lucasfutch/Arduino-Robot/images/reactivision-source.JPG

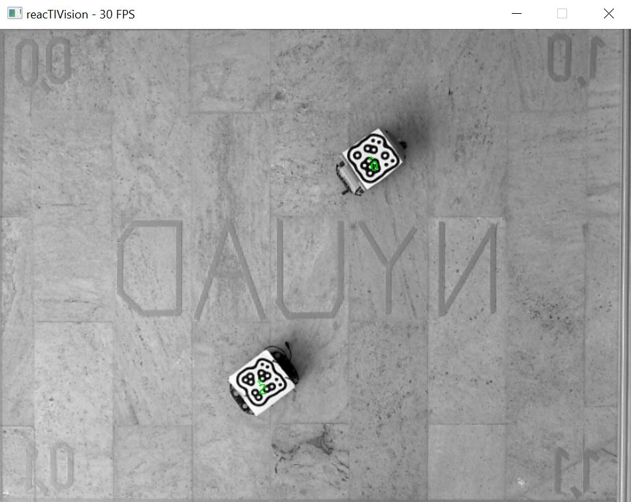
images/reactivision-source.JPG
