lucasfutch/Arduino-Robot/images/reactivision.JPG

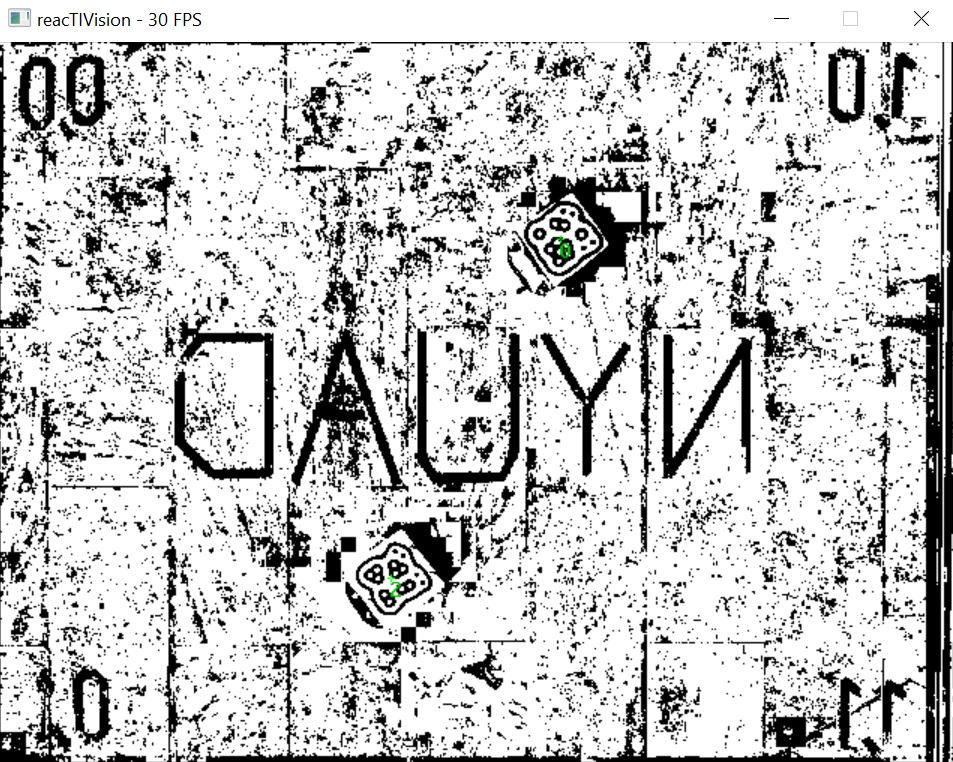
images/reactivision.JPG
