lucasfutch/Arduino-Robot/images/sideview2.jpg

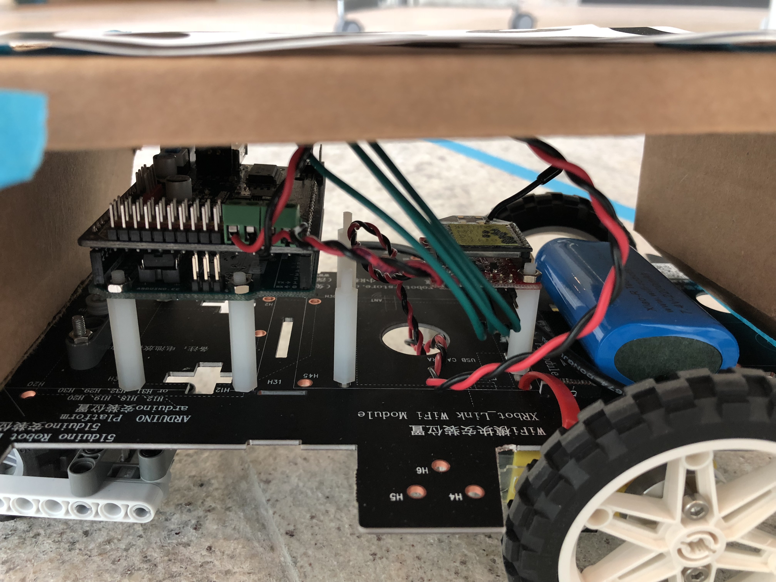
images/sideview2.jpg
