lucasfutch/Arduino-Robot/(threads)

Thread 1 (2018-04-02):

Finish documentation

dbcarelli, 2018-04-02:
Lucas:
1) user manual + installation
2) video
3) take pics of caster wheel
4) Add in throughput calculations - mention that maximum is actually 30 times per second because camera limitation

Dani:
1) Put graphs and explanation of PID attempt
2) Put pictures of AHRS
3) Add reactivation pics
4) explain why we used reactivision

dbcarelli, 2018-04-02:
Dani:
-Explain why we used XBee

lucasfutch, 2018-04-07:
done

Closed 2018-04-07.
