lucasfutch/Arduino-Robot/reacTIVision-windows-64bit/symbols/amoeba/small.pdf

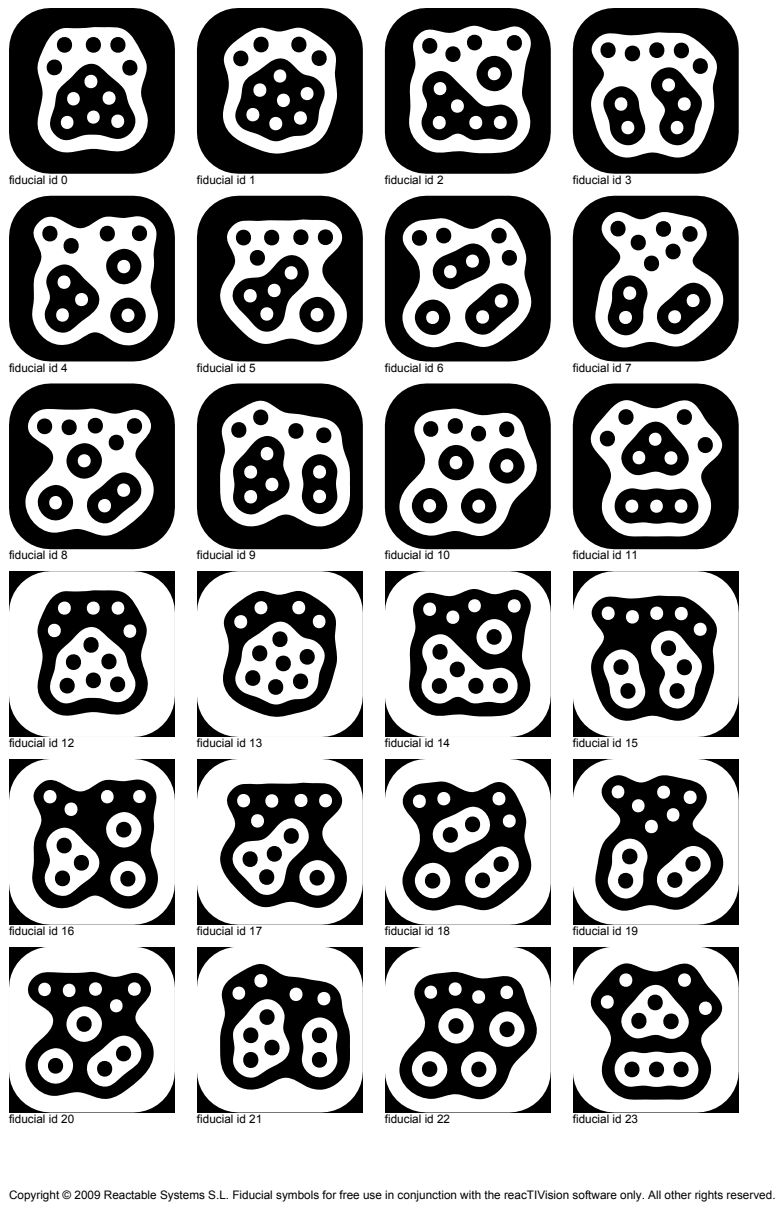
[picture p10: page 1]
fiducial id 0; fiducial id 1; fiducial id 2; fiducial id 3; fiducial id 4; fiducial id 5; fiducial id 6; fiducial id 7; fiducial id 8; fiducial id 9; fiducial id 10; fiducial id 11; fiducial id 12; fiducial id 13; fiducial id 14; fiducial id 15; fiducial id 16; fiducial id 17; fiducial id 18; fiducial id 19; fiducial id 20; fiducial id 21; fiducial id 22; fiducial id 23

Copyright © 2009 Reactable Systems S.L. Fiducial symbols for free use in conjunction with the reacTIVision software only. All other rights reserved.
