lucasfutch/Arduino-Robot/reacTIVision-windows-64bit/symbols/amoeba/legacy.pdf

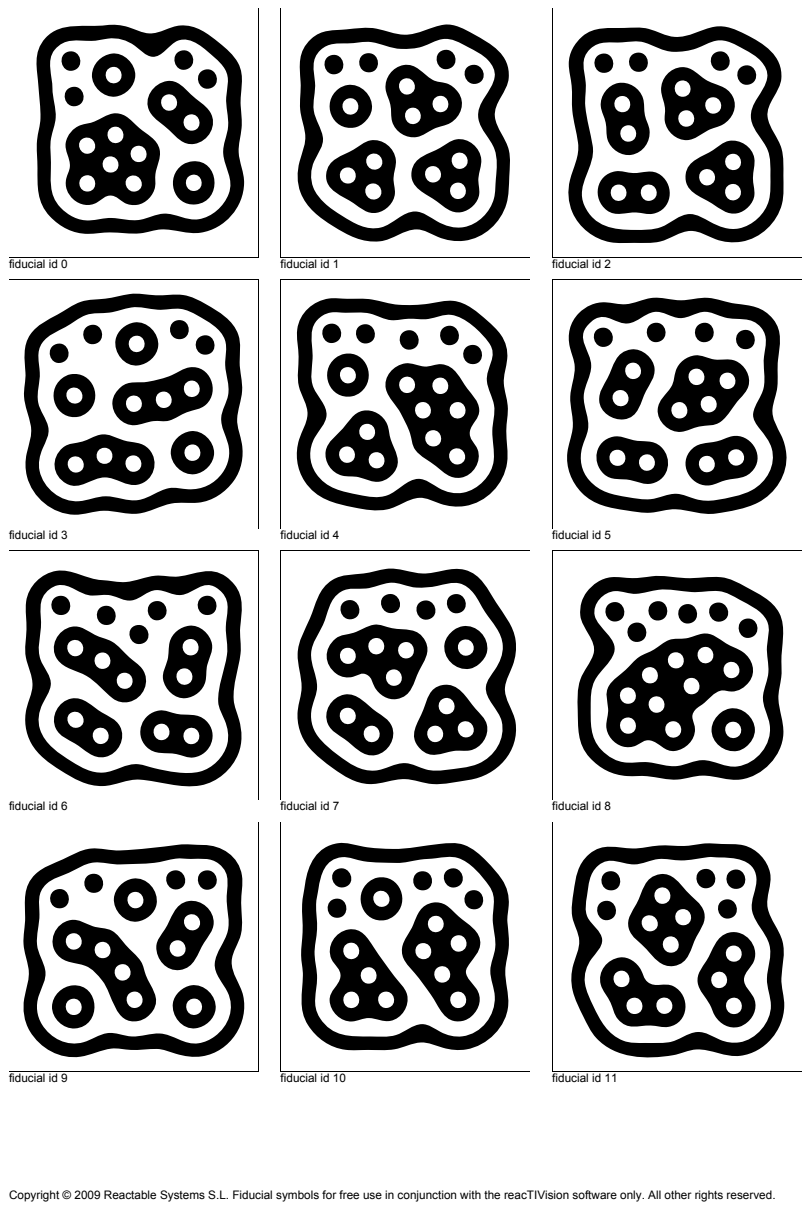
[picture p11: page 1]
fiducial id 0; fiducial id 1; fiducial id 2; fiducial id 3; fiducial id 4; fiducial id 5; fiducial id 6; fiducial id 7; fiducial id 8; fiducial id 9; fiducial id 10; fiducial id 11

Copyright © 2009 Reactable Systems S.L. Fiducial symbols for free use in conjunction with the reacTIVision software only. All other rights reserved.

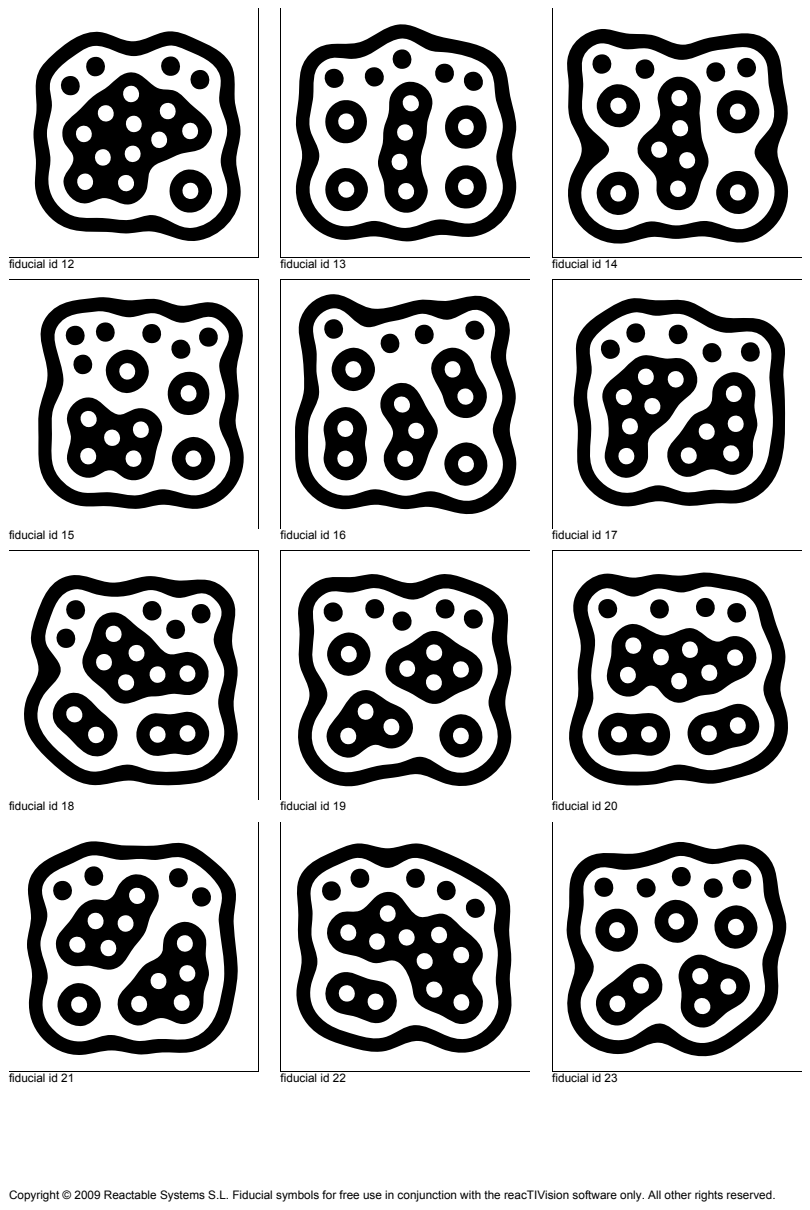
[picture p12: page 2]
fiducial id 12; fiducial id 13; fiducial id 14; fiducial id 15; fiducial id 16; fiducial id 17; fiducial id 18; fiducial id 19; fiducial id 20; fiducial id 21; fiducial id 22; fiducial id 23

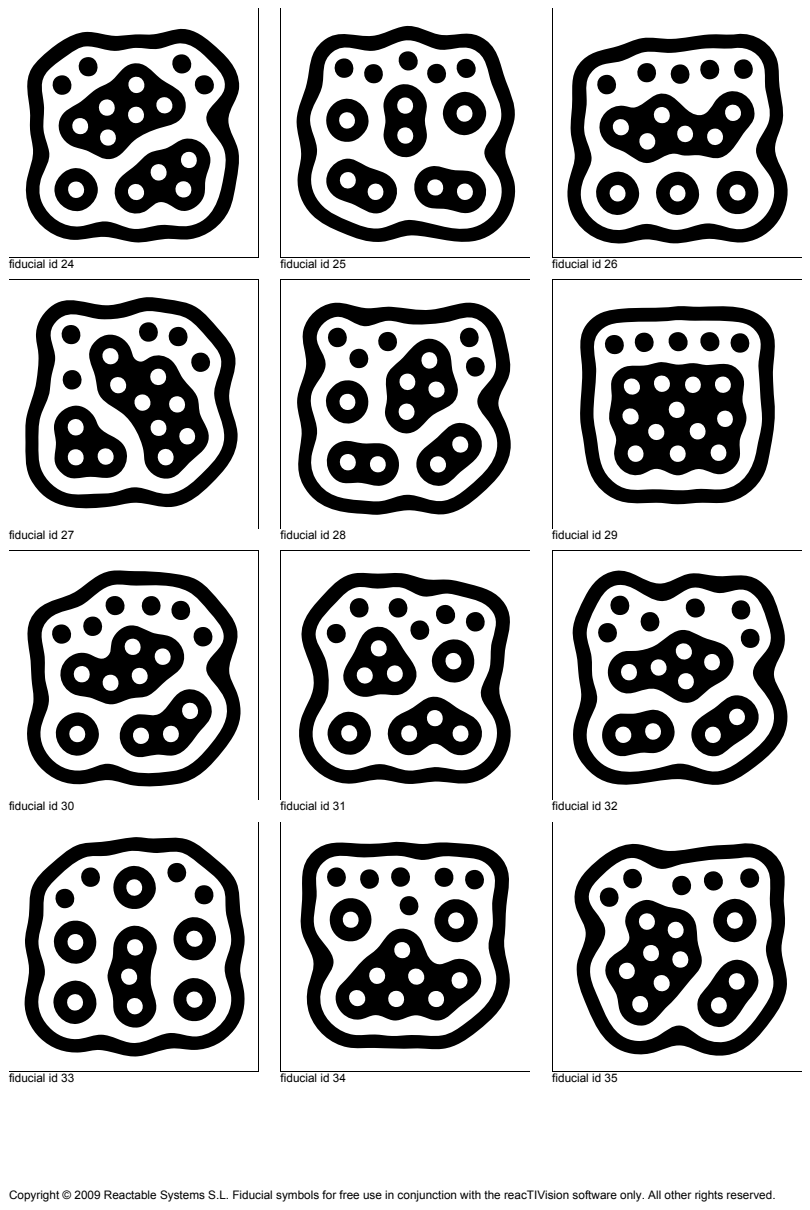
[picture p13: page 3]
fiducial id 24; fiducial id 25; fiducial id 26; fiducial id 27; fiducial id 28; fiducial id 29; fiducial id 30; fiducial id 31; fiducial id 32; fiducial id 33; fiducial id 34; fiducial id 35

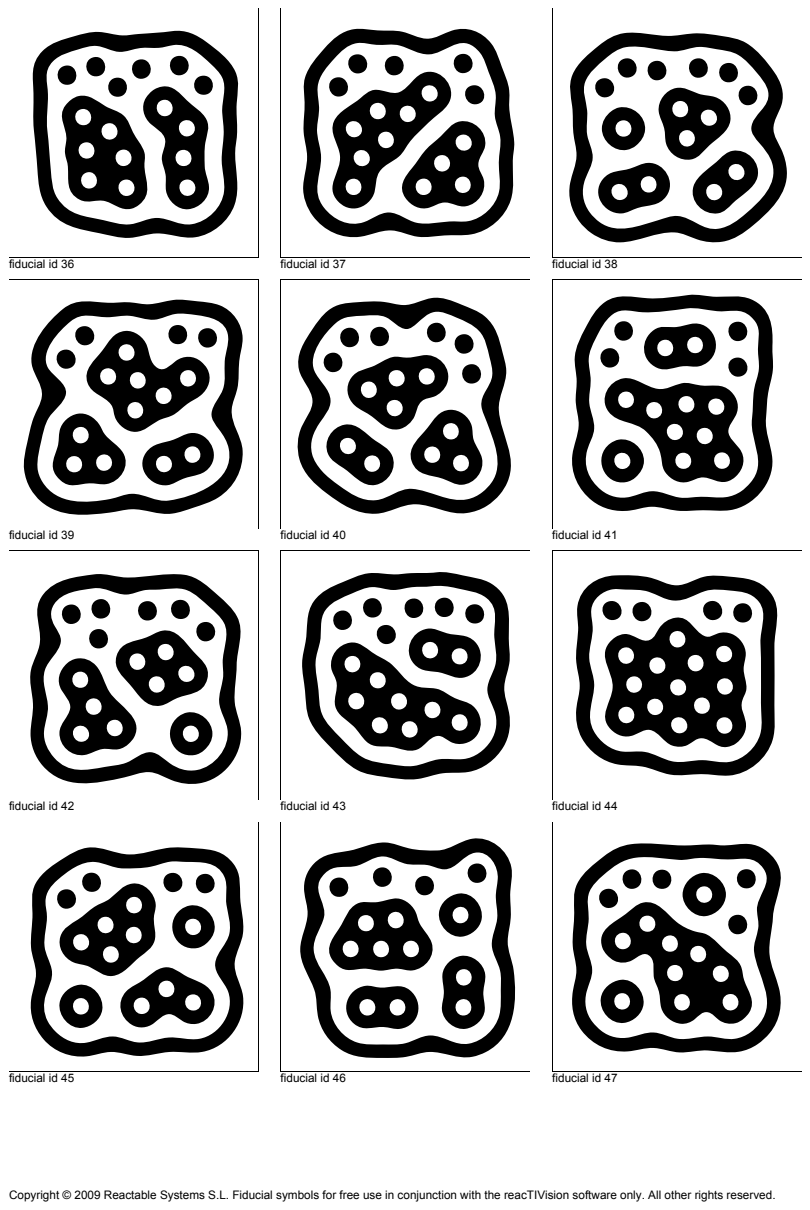
[picture p14: page 4]
fiducial id 36; fiducial id 37; fiducial id 38; fiducial id 39; fiducial id 40; fiducial id 41; fiducial id 42; fiducial id 43; fiducial id 44; fiducial id 45; fiducial id 46; fiducial id 47

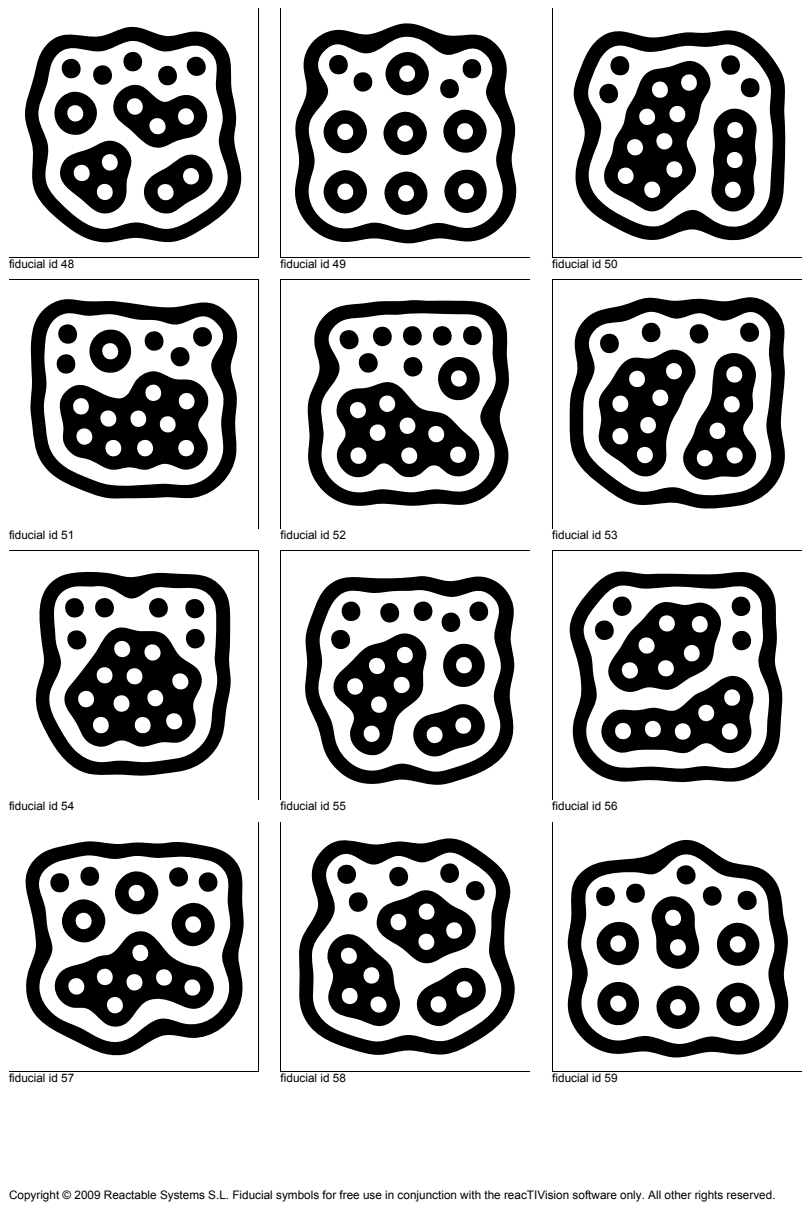
[picture p15: page 5]
fiducial id 48; fiducial id 49; fiducial id 50; fiducial id 51; fiducial id 52; fiducial id 53; fiducial id 54; fiducial id 55; fiducial id 56; fiducial id 57; fiducial id 58; fiducial id 59

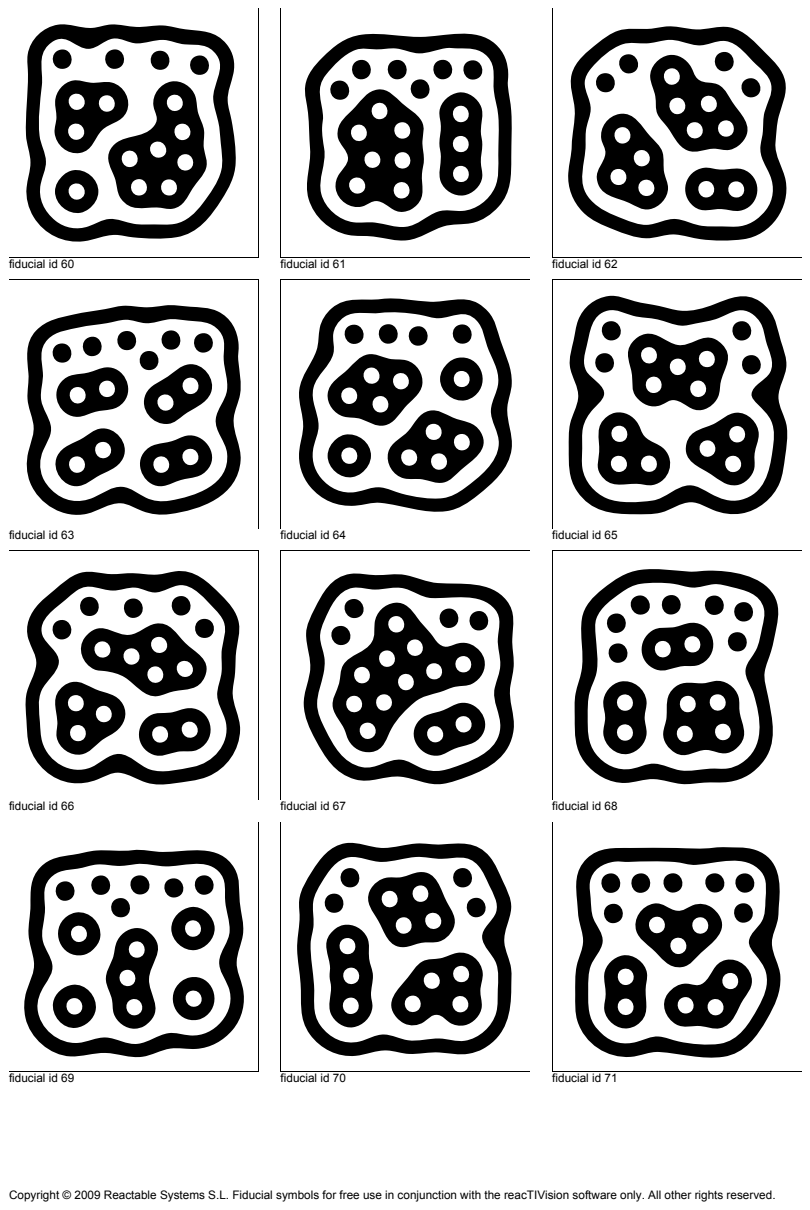
[picture p16: page 6]
fiducial id 60; fiducial id 61; fiducial id 62; fiducial id 63; fiducial id 64; fiducial id 65; fiducial id 66; fiducial id 67; fiducial id 68; fiducial id 69; fiducial id 70; fiducial id 71

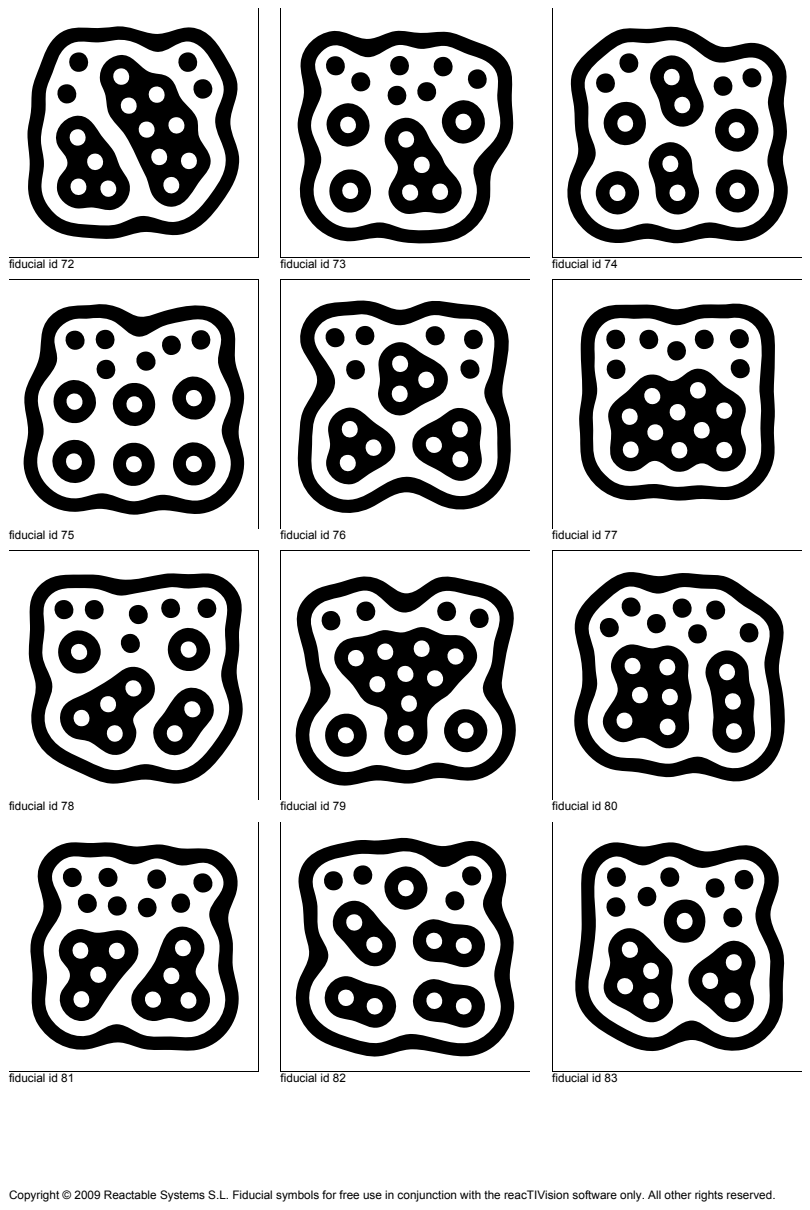
[picture p17: page 7]
fiducial id 72; fiducial id 73; fiducial id 74; fiducial id 75; fiducial id 76; fiducial id 77; fiducial id 78; fiducial id 79; fiducial id 80; fiducial id 81; fiducial id 82; fiducial id 83

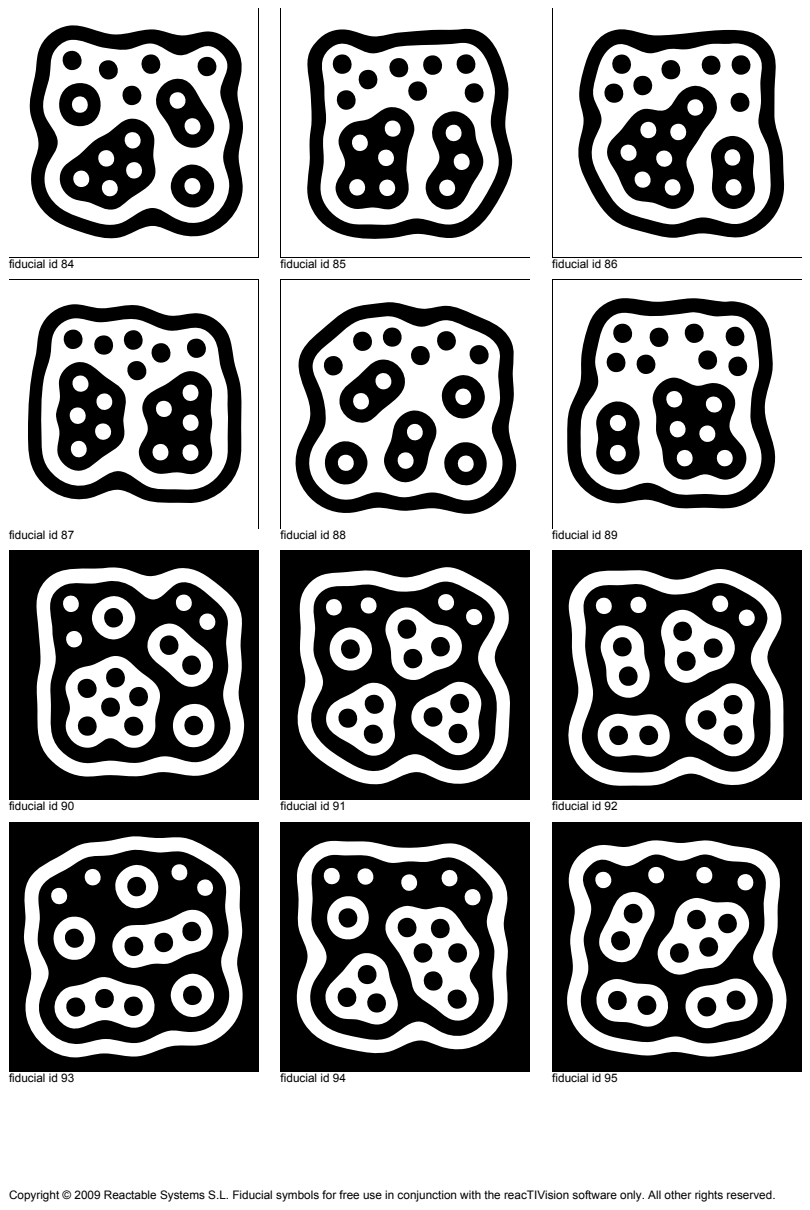
[picture p18: page 8]
fiducial id 84; fiducial id 85; fiducial id 86; fiducial id 87; fiducial id 88; fiducial id 89; fiducial id 90; fiducial id 91; fiducial id 92; fiducial id 93; fiducial id 94; fiducial id 95

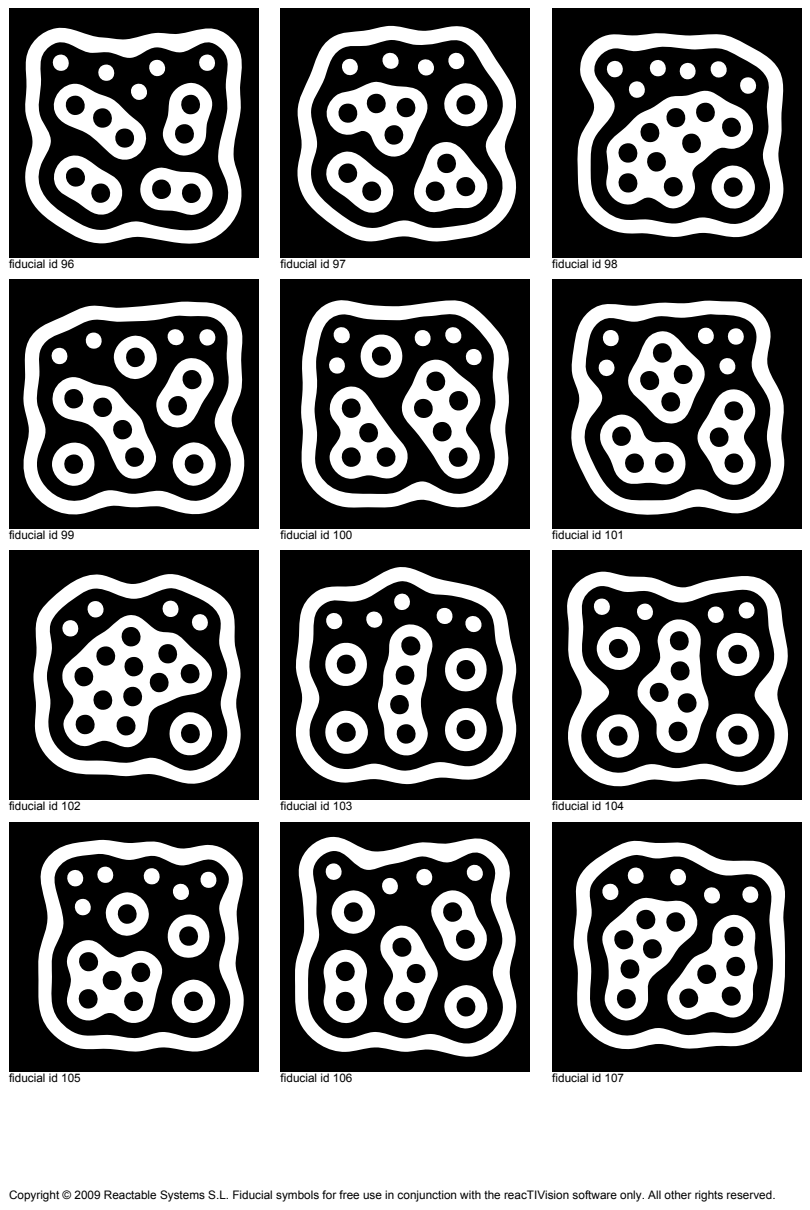
[picture p19: page 9]
fiducial id 96; fiducial id 97; fiducial id 98; fiducial id 99; fiducial id 100; fiducial id 101; fiducial id 102; fiducial id 103; fiducial id 104; fiducial id 105; fiducial id 106; fiducial id 107

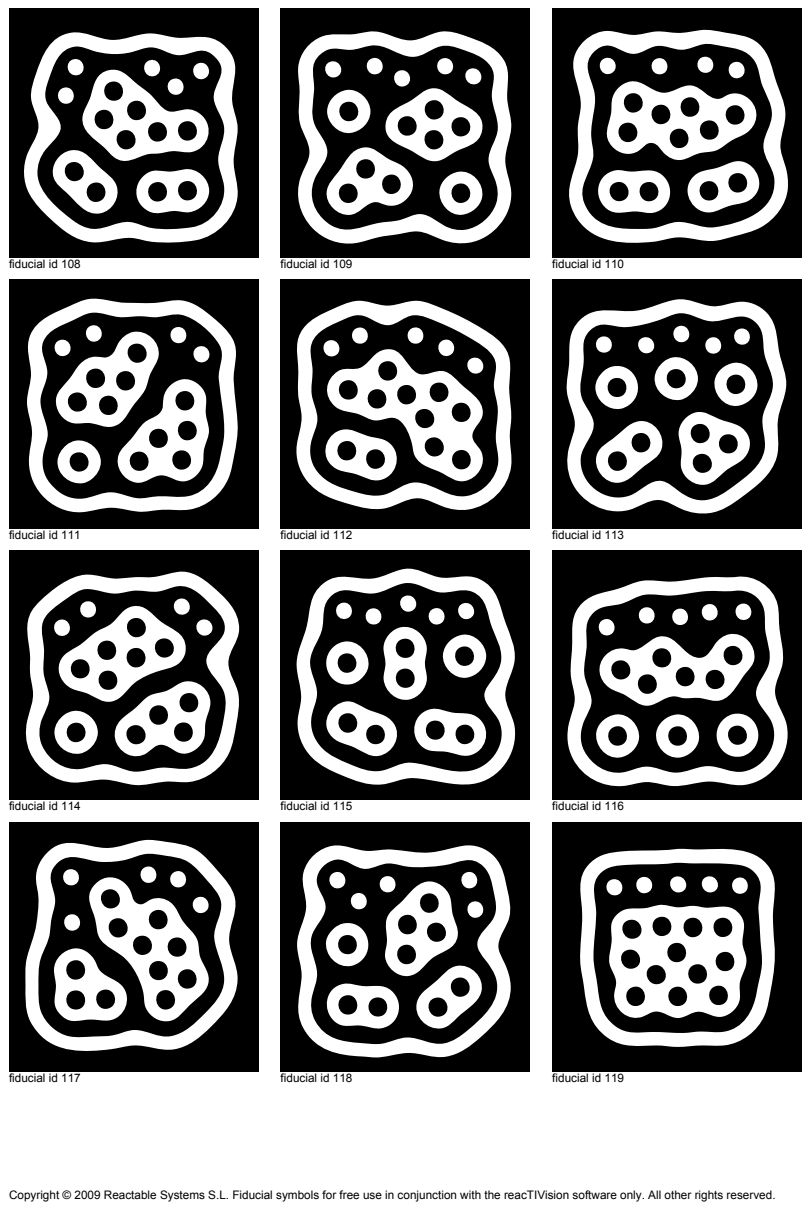
[picture p20: page 10]
fiducial id 108; fiducial id 109; fiducial id 110; fiducial id 111; fiducial id 112; fiducial id 113; fiducial id 114; fiducial id 115; fiducial id 116; fiducial id 117; fiducial id 118; fiducial id 119

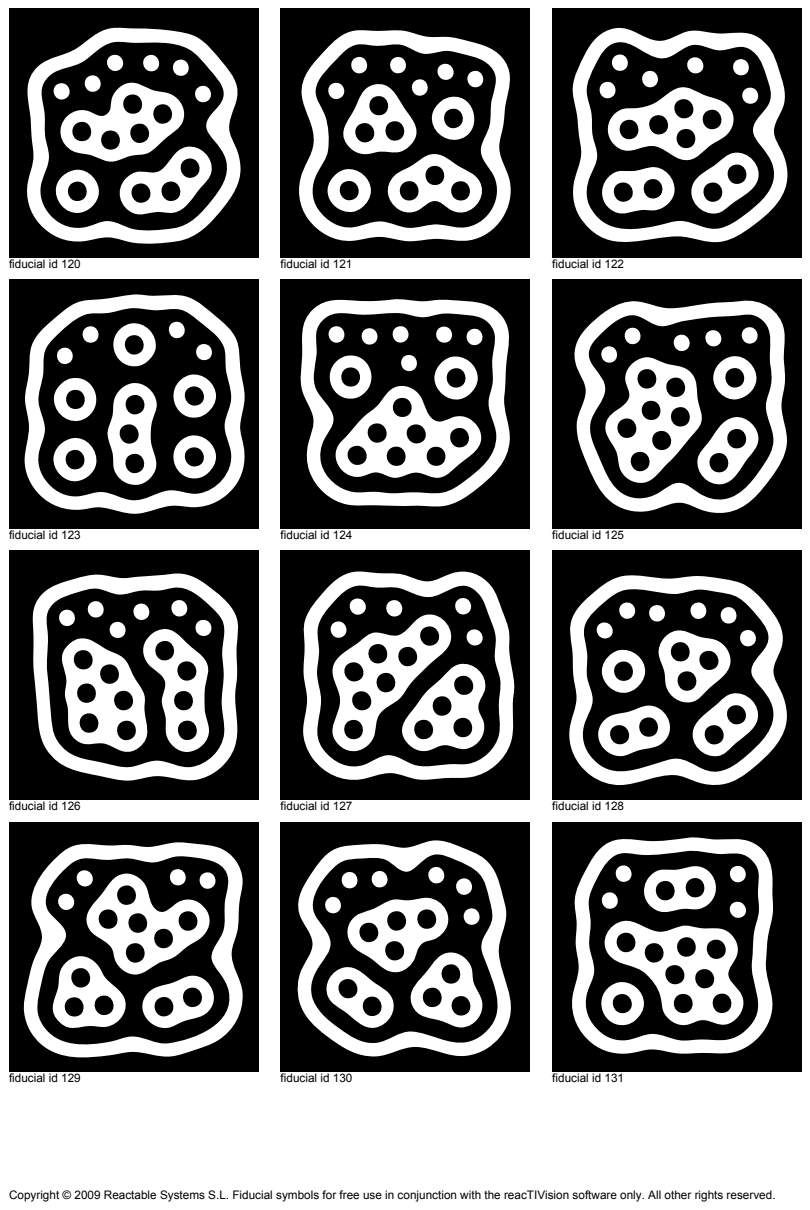
[picture p21: page 11]
fiducial id 120; fiducial id 121; fiducial id 122; fiducial id 123; fiducial id 124; fiducial id 125; fiducial id 126; fiducial id 127; fiducial id 128; fiducial id 129; fiducial id 130; fiducial id 131

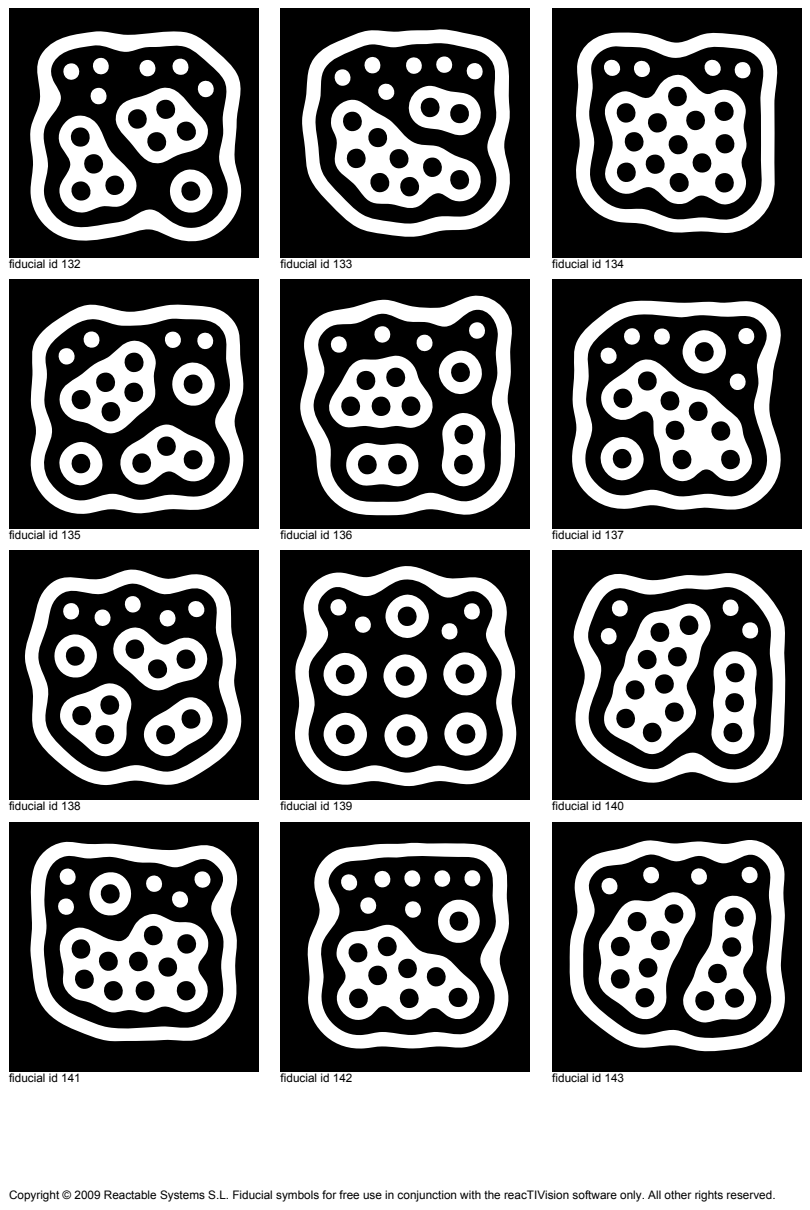
[picture p22: page 12]
fiducial id 132; fiducial id 133; fiducial id 134; fiducial id 135; fiducial id 136; fiducial id 137; fiducial id 138; fiducial id 139; fiducial id 140; fiducial id 141; fiducial id 142; fiducial id 143

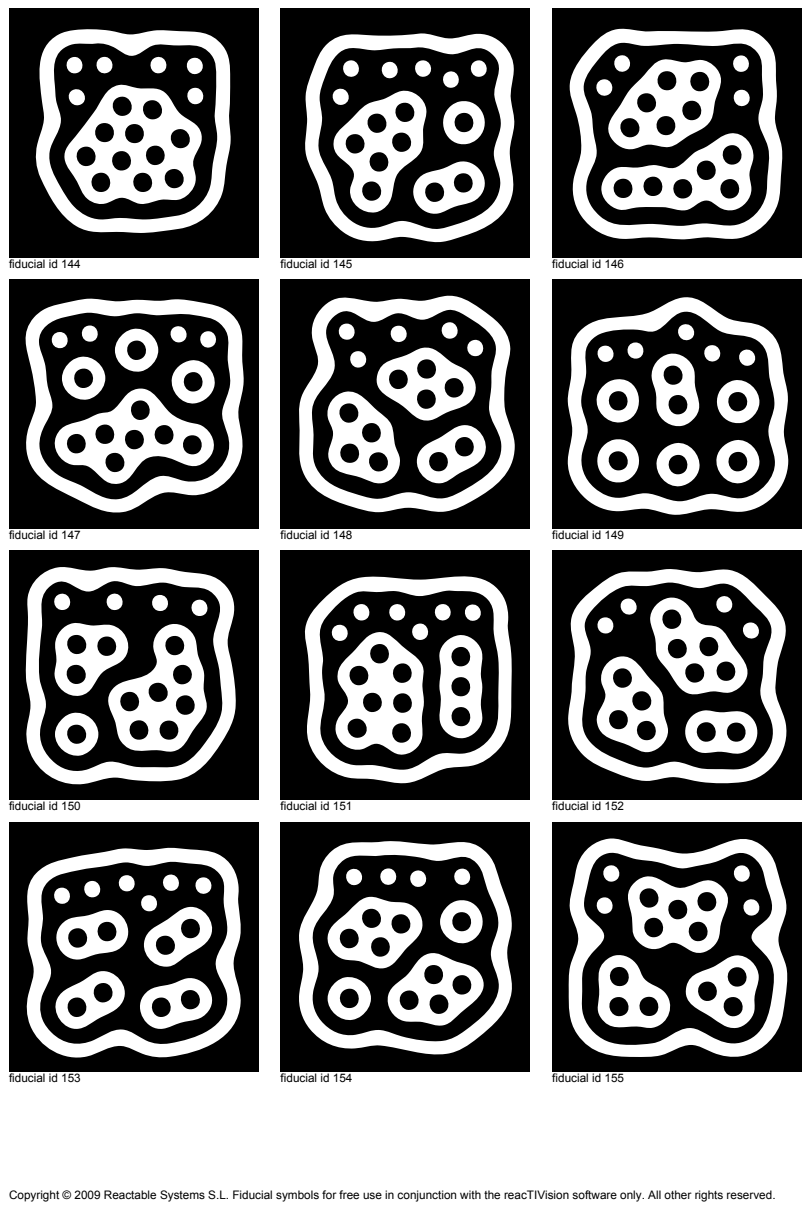
[picture p23: page 13]
fiducial id 144; fiducial id 145; fiducial id 146; fiducial id 147; fiducial id 148; fiducial id 149; fiducial id 150; fiducial id 151; fiducial id 152; fiducial id 153; fiducial id 154; fiducial id 155

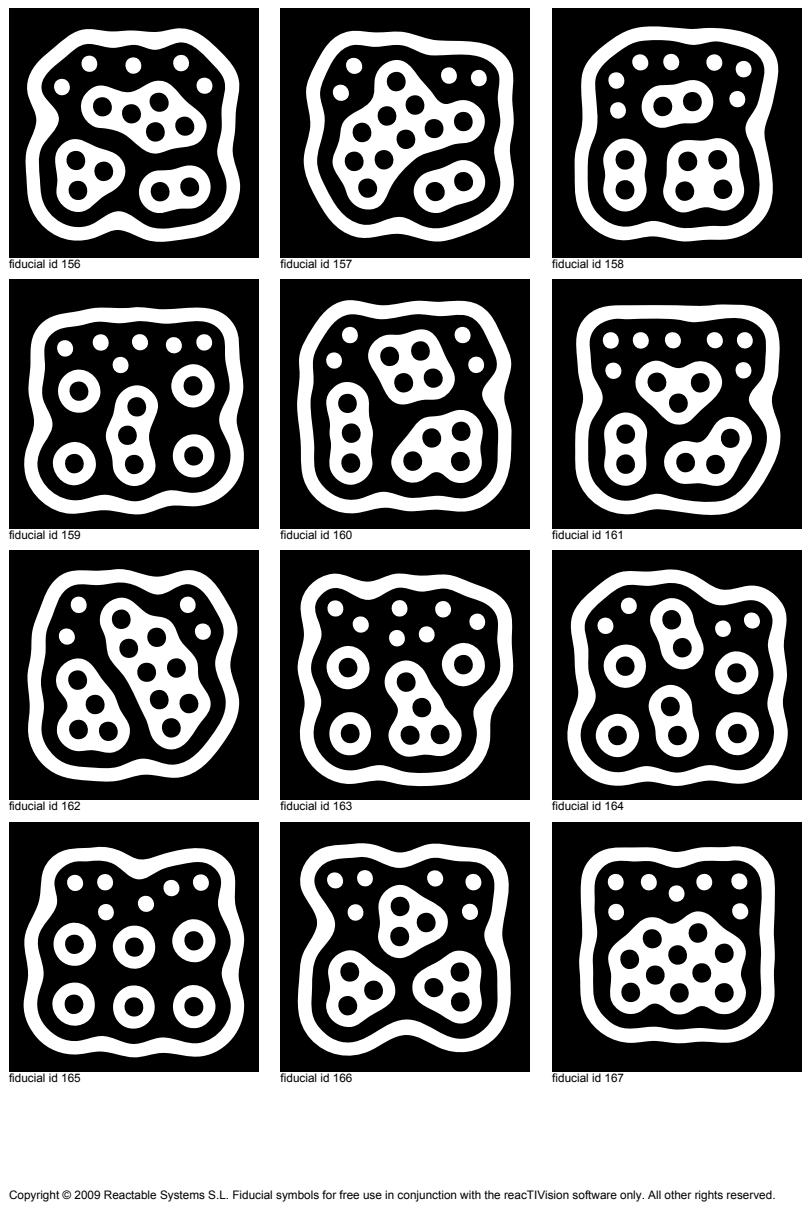
[picture p24: page 14]
fiducial id 156; fiducial id 157; fiducial id 158; fiducial id 159; fiducial id 160; fiducial id 161; fiducial id 162; fiducial id 163; fiducial id 164; fiducial id 165; fiducial id 166; fiducial id 167

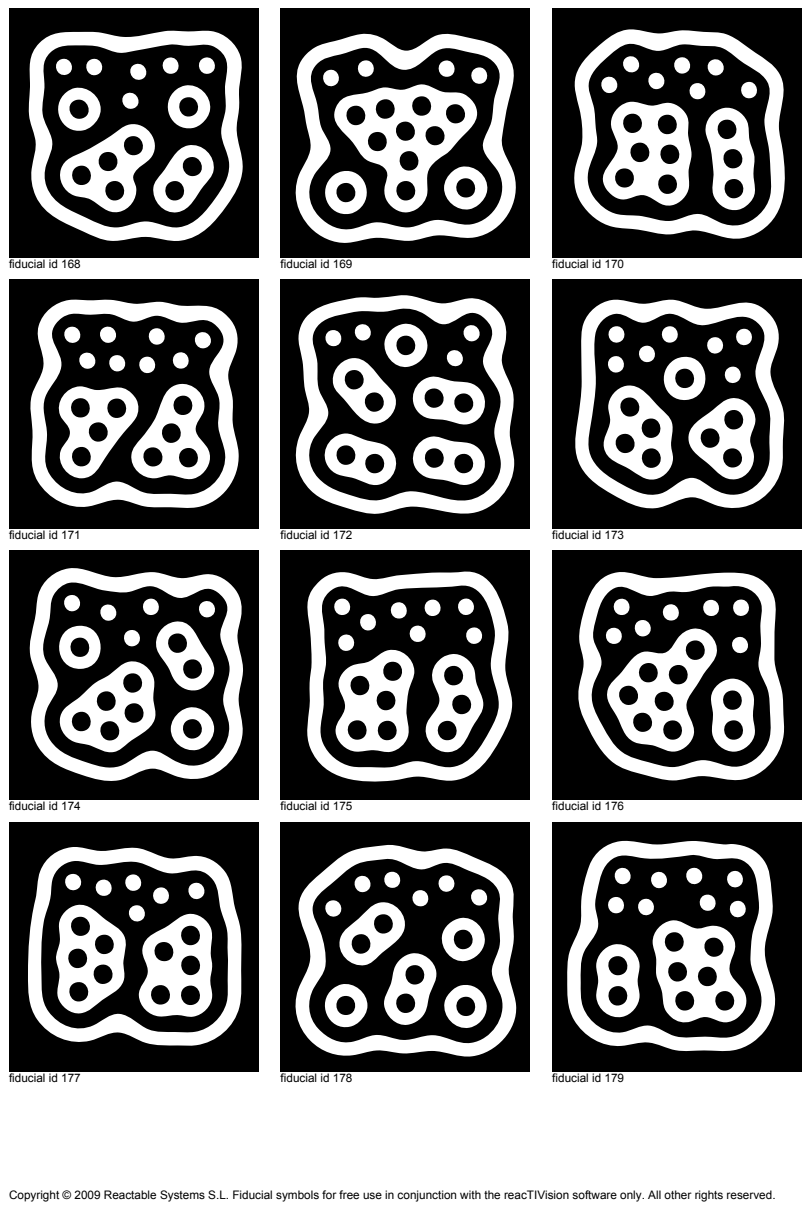
[picture p25: page 15]
fiducial id 168; fiducial id 169; fiducial id 170; fiducial id 171; fiducial id 172; fiducial id 173; fiducial id 174; fiducial id 175; fiducial id 176; fiducial id 177; fiducial id 178; fiducial id 179
