lucasfutch/Arduino-Robot/mainComputerControl/robot/rover.py

from controller import Controller
from matlab_port import MatlabPort
from navigator import Navigator

class Rover():
    def __init__(self,
                 tracker,
                 my_id,
                 target_id,
                 time_step,
                 max_pivot_input=50,
                 forward_speed=70,
                 pivot_threshold=30,
                 proportional_gain=5,
                 integrator_gain=0,
                 reversed=False,
                 comm_port=None):

        # system work horses
        self.controller = Controller(time_step,
                                     max_pivot_input,
                                     forward_speed,
                                     pivot_threshold,
                                     proportional_gain,
                                     integrator_gain,
                                     reversed,
                                     comm_port)
        self.navigator = Navigator()
        self.tracker = tracker
        self.id = my_id
        self.target_id = target_id

        # state parameters
        self.current_heading = 0
        self.pos = [0, 0]
        self.target_pos = [0, 0]
        self.desired_heading = 0

    def update_state(self,
                     target_pos=None,
                     desired_heading=None,
                     heading_correction=None):

        # update my state parameters
        self.current_heading = self.tracker.get_heading(self.id)
        self.pos = self.tracker.get_pos(self.id)

        # update my target state parmeters
        if (target_pos):
            self.target_pos = target_pos
            if (self.pos and self.target_pos):
                self.desired_heading = self.navigator \
                .get_target_heading(self.pos, self.target_pos)
            else:
                self.desired_heading = None
        elif (desired_heading):
            self.desired_heading = desired_heading
            self.target_pos = None
        elif (heading_correction):
            # make sure desired_heading is not None
            if (self.desired_heading == None):
                self.desired_heading = self.tracker.get_heading(self.id)

            # the tracker could still return None...
            if (self.desired_heading == None):
                return

            # calculate the new heading!
            new_heading = (self.desired_heading+heading_correction)%360
            self.desired_heading = new_heading
            self.target_pos = None
        else:
            self.target_pos = self.tracker.get_pos(self.target_id)
            if (self.pos and self.target_pos):
                self.desired_heading = self.navigator \
                .get_target_heading(self.pos, self.target_pos)
            else:
                self.desired_heading = None

    def update_action(self):

        if (self.pos and self.desired_heading):
            # there is enough information to act on
            if (self.target_pos and self.navigator.has_arrived()):
                # we have arrived at our destination
                self.controller.coast()
            else:
                # we are given a target heading
                self.controller.update_motors(self.current_heading,
                                              self.desired_heading)
        else:
            # no new data (fiducial is not in view)
            self.controller.coast()

    def stop(self):
        self.controller.stop()

    def coast(self):
        self.controller.coast()

    def end(self):
        self.controller.close()
