lucasfutch/Arduino-Robot/(commit log)

2018-03-22 Add MPU-6050 code from Dani's presentation about imus.
2018-03-27 added number processing for data on xbeeControl, and added gyroscope data acquisition on robotControl
2018-03-29 updated robotMovement to correct terms
    [robotMovement.ino]
2018-03-30 Fix folder naming error.
    [robotMovement.ino]
2018-04-25 bugfixes for tricicle rover
    [rover.py]
2018-04-26 Add reversed boolean when instantiating a Rover
    [controller.py, rover.py]
2018-04-26 Reset Ki to 0
    [controller.py]
2018-04-26 bugfix: write 255 if xbee input is tool large.
    [xbee.py]
2018-04-30 Moved Reset so that the simulation would fully stop at the end of each round This will hopefully minimize non-recored motor use for our real world setting
2018-07-07 Fix MAJOR error in target heading calculations
    [navigator.py]
2018-07-07 Remove print statements
2018-07-23 Add coulomb agent. Currently only evades walls.
2018-08-14 Handle heading_correction=0 case in update_state method
